sui001/Servo-notes/steptest_spectrograms.png

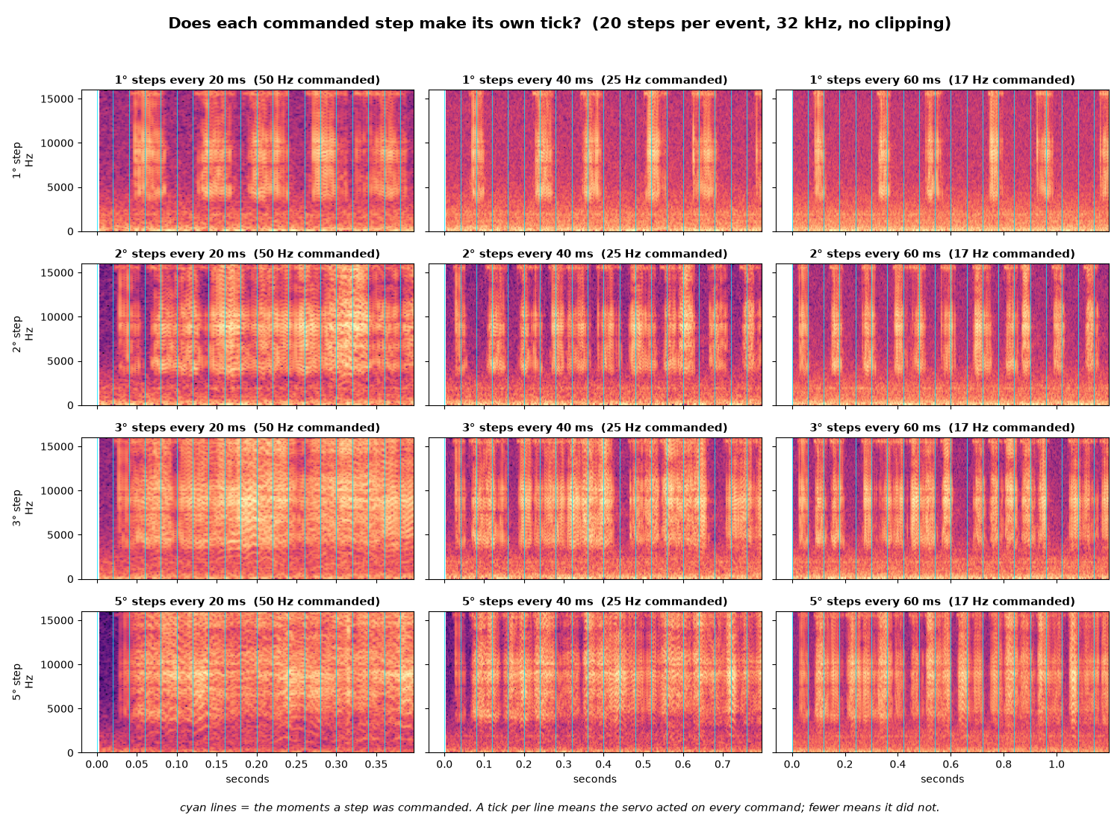
steptest_spectrograms.png
