sui001/Servo-notes/conttest_analysis.png

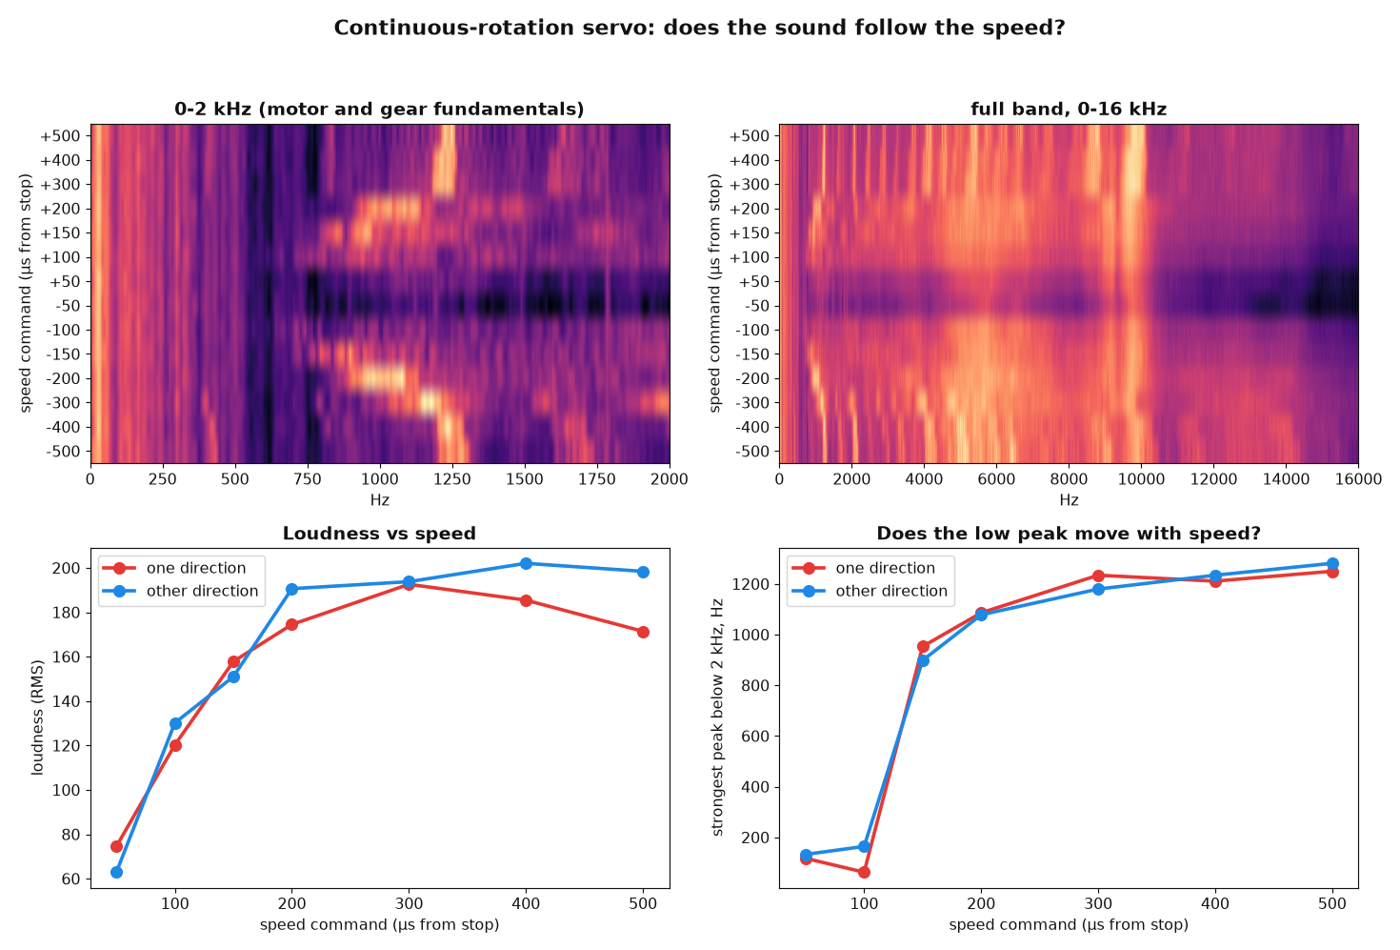
conttest_analysis.png
