sui001/Servo-notes/dirtest_analysis.png

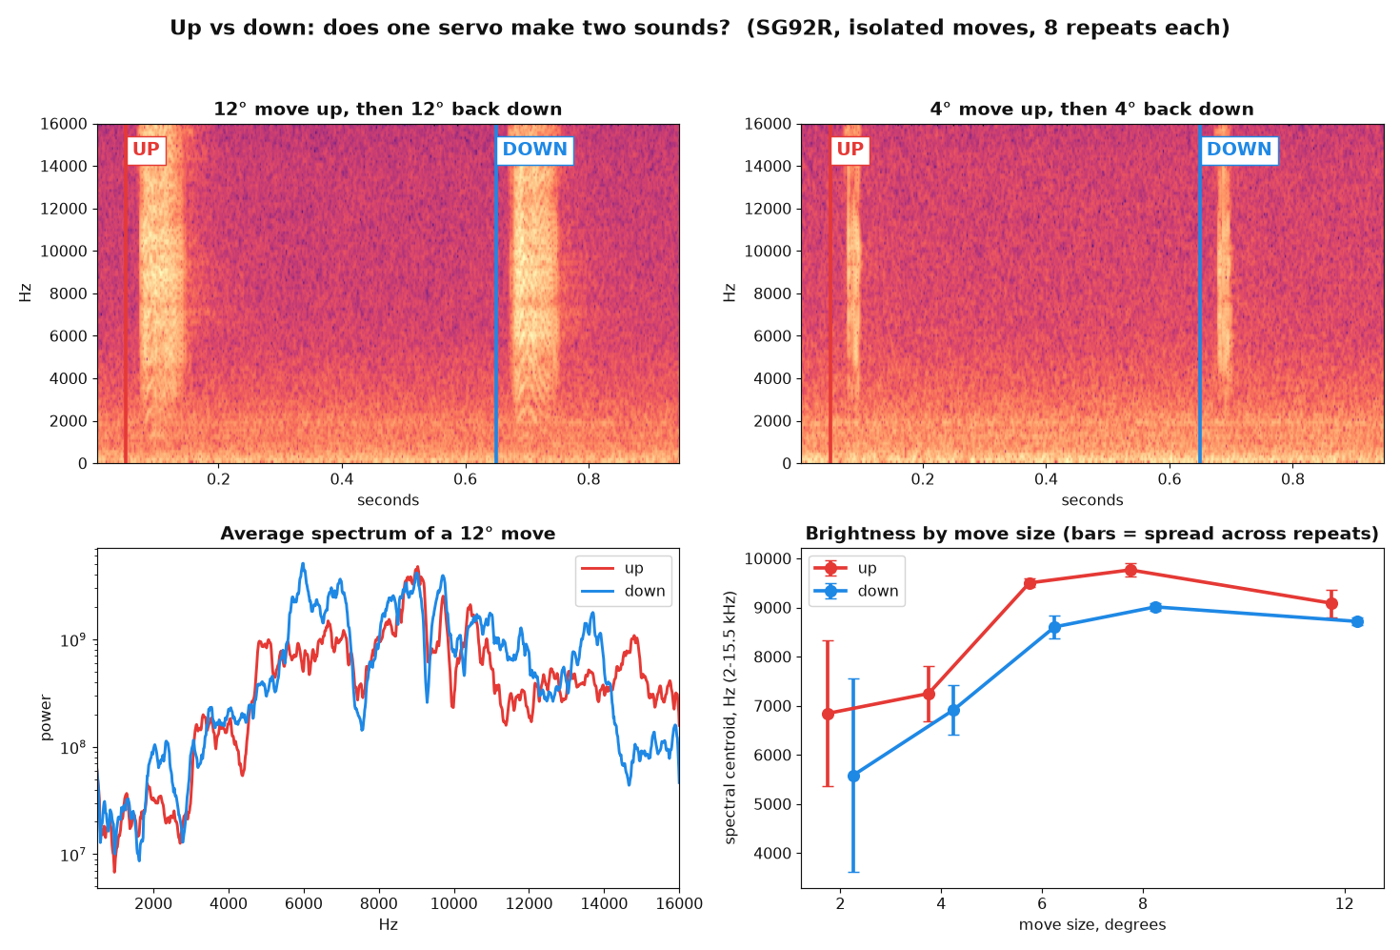
dirtest_analysis.png
