sui001/Servo-notes/firsttest_analysis.png

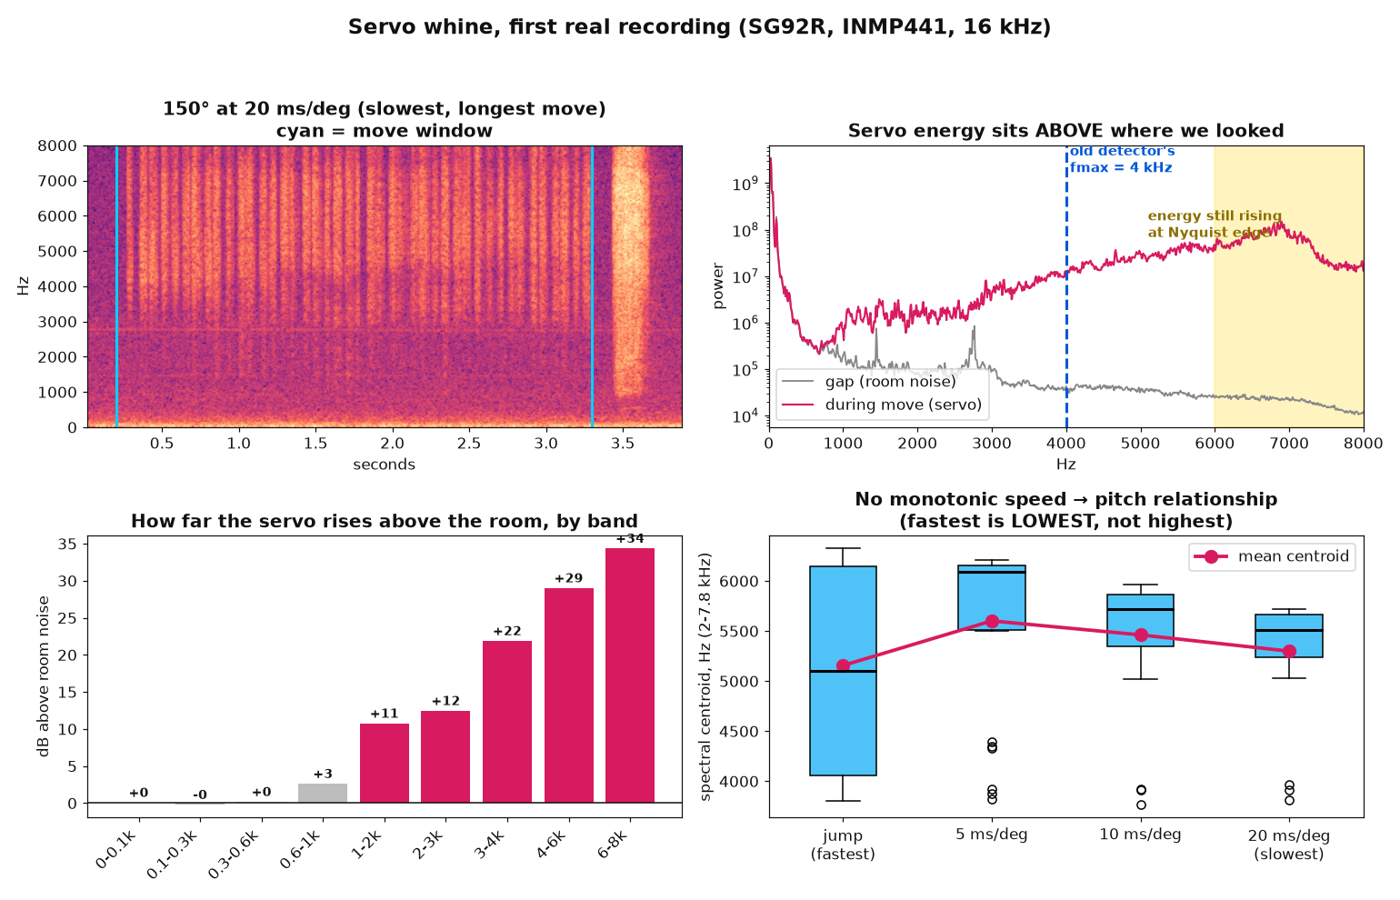
firsttest_analysis.png
