sui001/Servo-notes/thirdtest_analysis.png

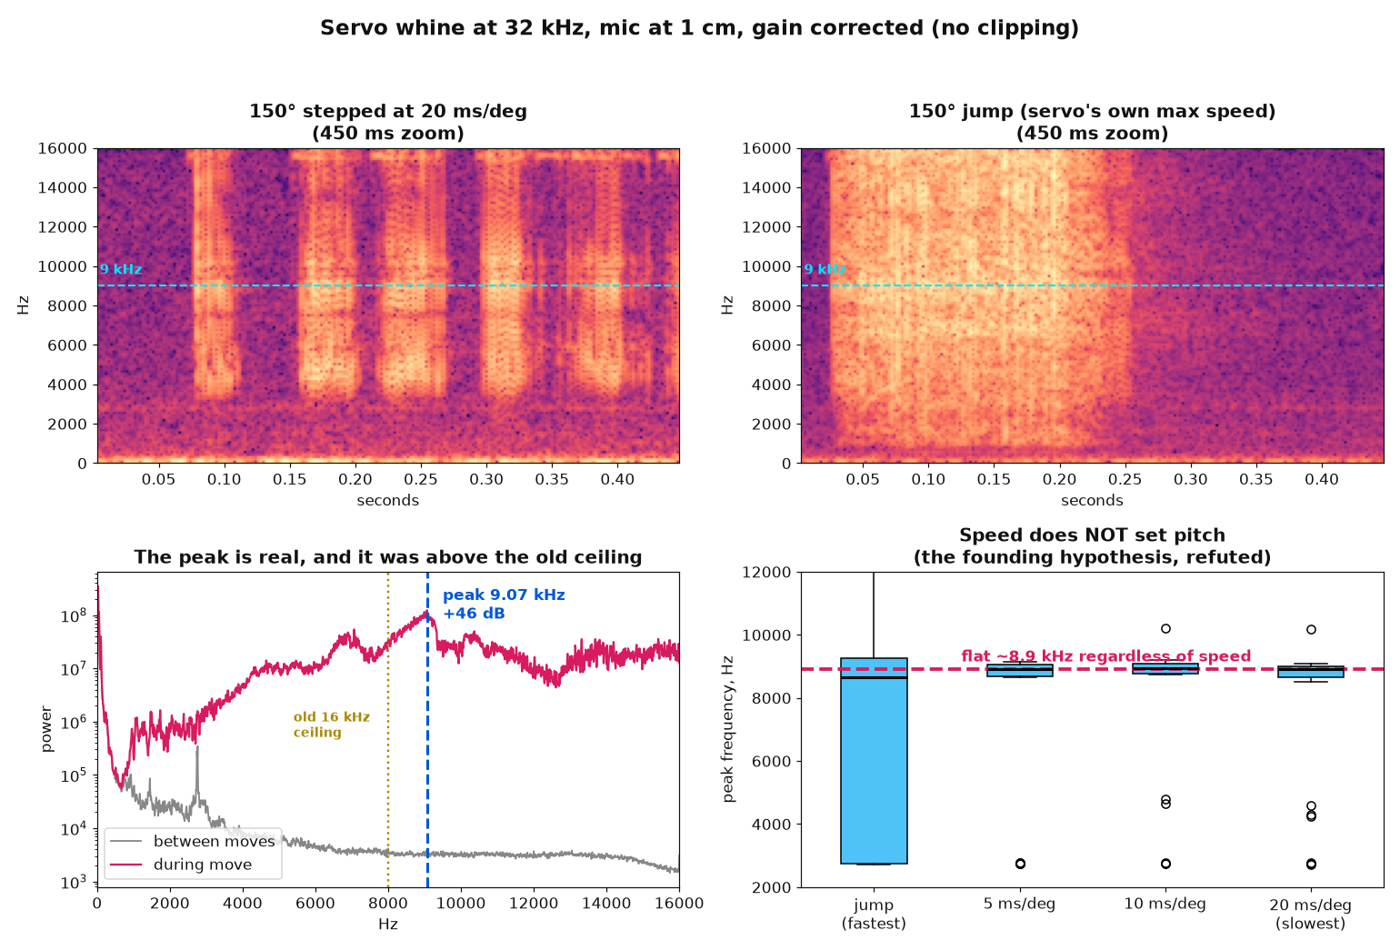
thirdtest_analysis.png
