sui001/Servo-notes/(commit log)

2026-09-14 Add first-pass servo note-scan test rig
    ESP32-S3 + INMP441 firmware and a serial-side pitch analyzer for
    testing whether servo gear whine is pitched enough to use as a sound
    source. Untested against real hardware yet.
2026-09-14 Update pin assignments for actual hardware in hand
    Mic on 11/12/13 and servo on GPIO8, matching the ESP32-S3 that's
    already wired up (repurposed from Groundskeeper) rather than the
    speculative 4/5/6/7 layout from before hardware was on the bench.
2026-09-14 Fix cmds[] buffer overflow that was crash-looping the board
    The full positional sweep (3 repeats x 9 distances x 4 step rates,
    with 1deg/step commands for the non-jump rates) needs ~4986 command
    slots; the array was sized for 2000. Overflow silently corrupted
    adjacent globals, which looked exactly like a hardware fault (panic
    handler double-faulting before it could print a real backtrace) with
    the mic and servo wired up separately both working fine on their own.
    Bumped to 6000 and added a hard halt-with-message if it's ever hit
    again, instead of wrapping silently.
    Also required flashing with CDCOnBoot=cdc (USB CDC On Boot: Enabled
    in the IDE) to actually see the board's own serial output at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
    [servo_mic_test.ino]
2026-09-14 Keep commanded angles inside the servo's actual range
    HOME_ANGLE was 90 with distances up to 150, so the three largest
    steps asked for 180/210/240 deg. Past 180 is unreachable on a
    positional servo, so those events commanded nothing, the servo sat
    still at home, and the plan still recorded an event as though a move
    had happened. Home moves to 15 deg, which keeps the full 5-150 spread
    of test distances and tops out at 165.
    Angles are now claimed on the way into the command list rather than
    trusted: an out-of-range target halts with a message instead of
    quietly producing an event with no movement behind it.
2026-09-14 Size each event's window from its own move duration
    Every event got a fixed 1600ms slot, but a stepped move takes
    distance x stepDelay: 150 deg at 20ms/deg needs 3000ms. Nine of the
    108 events outlasted the 700ms analysis window and four outran the
    slot entirely, leaving step commands pending as the next event began.
    Events then fired late while the plan still reported the original
    start_ms, so analyze.py sliced the wrong audio for everything after
    the first overrun, drifting ~3.1s per repeat.
    The window is now max(MOVE_WINDOW_MS, moveDur + SETTLE_MS) and goes
    into the plan as that event's dur_ms, which analyze.py already reads
    per event. Return-home moved to after the window closes so its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
    [servo_mic_test.ino]
2026-09-14 Reset the board before waiting for the test plan
    The plan is printed once, at boot, so connecting to a board that was
    already running meant waiting forever for a delimiter that had long
    gone past. The script sat silent with no output, which read as a
    hardware problem rather than a handshake that could never complete.
    Two things behind it that would have surfaced next: the header after a
    reset carries the ROM's own boot banner ahead of our JSON, so parsing
    the whole header as JSON throws, and audio arriving in the same read
    as the delimiter was discarded, shifting every slice by that much.
    Plan reads now also time out with the bytes they did see, rather than
    blocking indefinitely.
    Co-Author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
    [analyze.py]
2026-09-14 Record at 32 kHz and stop reporting pitch that isn't there
    The first real recording put servo energy at +34 dB over room noise in
    the 6-8 kHz band and still climbing at the 8 kHz Nyquist edge, so 16 kHz
    was cutting the spectrum off rather than capturing it. Sampling moves to
    32 kHz, measured at 63.0 KB/s sustained against the 62.5 KB/s the stream
    needs, so the link keeps up. The plan now reports the rate it was built
    with instead of a hardcoded 16000, and the PC side reads the rate from
    the plan: the two could previously disagree with nothing to catch it.
    The detector searched 60-4000 Hz, below where the noise actually lives,
    and returned an argmax that on broadband noise always lands on th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
    [analyze.py, servo_mic_test.ino]
2026-09-14 Convert the mic at the right scale, and clamp instead of wrapping
    The INMP441 gives 24 bits left-justified in a 32-bit slot, so >>16 is
    full scale for 16-bit. This was >>14, four times hotter. At 5 cm that
    went unnoticed; at 1 cm it clipped 1.09% of samples across 50 of the
    108 events. Clipping invents broadband harmonics, so it corrupts the
    one thing the rig exists to measure: whether the whine is a tone or a
    noise band. Half the second recording cannot answer that question.
    The cast was also unclamped, so a sample past full scale wrapped and
    flipped polarity, reading as a spike. An overload looked like noise in
    the spectrum rather than like an overload. It now clamps.
    analyze.py reports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
    [analyze.py, servo_mic_test.ino]
2026-09-14 Add the step-size test, and an onset detector that was checked first
    servo_step_test holds the number of steps fixed and varies step size
    and interval, to find whether the tick rate follows the commanded
    interval or the step size. Recorded at >>17 because the bigger steps
    hit harder: move RMS went 44/79/148/246 for 1/2/3/5 degree steps and
    the 5 degree ticks clipped at the previous setting.
    onsets.py times the bursts, and is checked against synthetic tick
    trains before being pointed at real audio. That check earned its keep
    twice. The first version reported 164.9 Hz for every input including
    pure noise, which is exactly one over its own refractory gap: the
    threshold sat inside the noise so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
    [analyze.py, onsets.py, servo_step_test.ino]
2026-09-14 Add the pattern sequencer, and keep the recordings behind the findings
    servo_pattern.ino plays the servo instead of measuring it. The rig has
    answered what it was built to ask: the noise sits at a fixed ~9 kHz
    whatever is commanded, it is a noise band rather than a tone, and what
    actually varies is loudness, which ran 44/79/148/246 RMS for 1/2/3/5
    degree steps. So the sequencer has a hit, a velocity and a rhythm, and
    no note parameter, because there is no note. A hit is a move, since the
    sound only exists while the servo travels, so it ping-pongs either side
    of a centre and can loop without running out of travel.
    The tempo ceiling is deliberately past what the servo can follow.
    Sixteenths a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
    [firsttest.csv, secondtest.csv, steptest.csv, steptest2.csv, thirdtest.csv]
2026-09-14 Two voices from one servo: hi on the way up, lo on the way down
    Heard first, then measured. The sequencer alternates direction on every
    hit and it sounded like a high and a low drum. servo_direction_test
    records isolated up and down moves separately: from 6 degrees up the
    upward move is clearly brighter, centroid 9502 vs 8606 Hz at 6 degrees
    and 9767 vs 9013 at 8, each difference five to seven times the spread
    across repeats. At 2-4 degrees there is no reliable difference. The
    earlier tests could not have found this, since they measured only the
    outbound move and discarded every return as contamination.
    The sequencer now takes h (hi, upward) and l (lo, downward) alongside
    x for alternating,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
    [dirtest.csv]
2026-09-14 Continuous-rotation servo has pitch, and a first go at a tune
    The positional servo's noise sat at ~9 kHz whatever was commanded. The
    continuous-rotation servo does not: writeMicroseconds sets real motor
    speed, and a peak below 2 kHz follows it, 898 Hz at 150 us from stop
    rising through 1074, 1152 and 1238 to 1285 Hz at 500 us one way. About
    six semitones. Under 100 us it barely turns and there is nothing to hear.
    servo_tune.ino streams the mic and takes W <us> speed commands, with a
    3 s watchdog so a dead PC script cannot leave it spinning. tune.py
    plays the first phrase of Happy Birthday from that measured curve and
    checks each note against its target. First attempt: A, G and C within
    30 c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
    [conttest.csv]
2026-09-14 Calibrate before every tune, and keep the sweep when it refuses
    The stored speed-to-pitch table had drifted by the second session, so
    tune.py now sweeps 100-500 us in 10 us steps before playing. The first
    version of that filter kept a point only if it beat the last one kept,
    and near the deadband the servo is barely turning, so the loudest bin
    is noise: a stray 1286 Hz at 120 us became the floor and threw away
    everything genuinely lower, cutting the range to 3.3 semitones. Points
    now need a clear peak (prominence 15 or more over the band median), and
    the curve is the longest rising chain, so one bad reading is skipped
    rather than trusted. Same servo, same session: 891-1340 Hz, 7.1
    semitones.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
    [tune.py]
2026-09-14 Continuous servo: steerable pitch, not tuned pitch
    Third attempt at the tune, with every repeat or step down approached
    from below, on the theory that pitch depends on which way the motor
    comes to a speed. It does not seem to: the G that theory was meant to
    fix landed at 1037 Hz with the dip and 1038 without. 1 of 6 notes
    within 30 cents again. The same speed command just does not reliably
    give the same pitch, and around 1100-1650 Hz the strongest peak hops
    between partials inside one held note.
    The dip is kept only for repeated notes, where it re-attacks, and the
    comment no longer claims a cause the data ruled out. README records
    where this stands: about 7 semitones of range, no precise in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
    [tune.py]
